Mohammad-Altamash-zia/SmartAqua/Images/PumpSideDivice.png

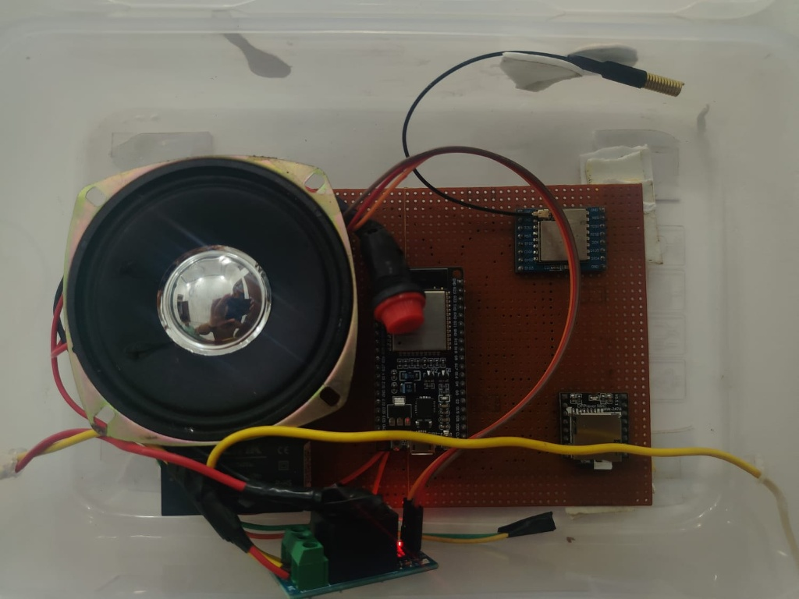
Images/PumpSideDivice.png
