Mohammad-Altamash-zia/SmartAqua/Images/TankSideDivice.png

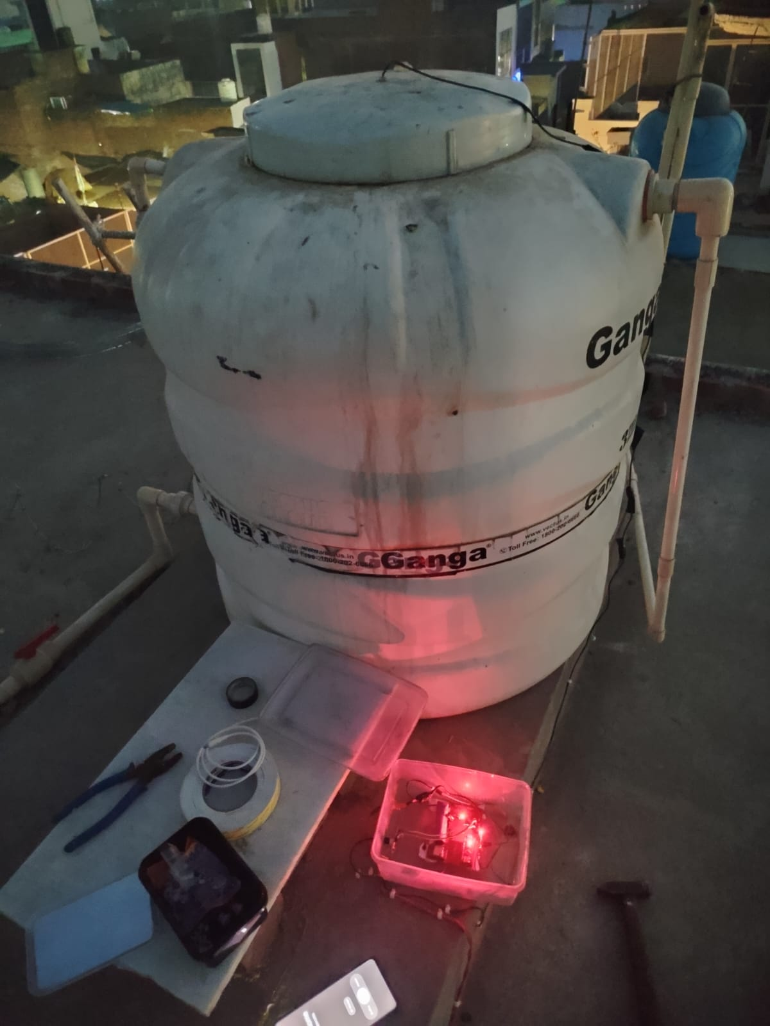
Images/TankSideDivice.png
