Mohammad-Altamash-zia/SmartAqua/SmartAqua_Documentation.docx

# SmartAqua: A Long-Range IoT Water Management System

Comprehensive Project Report & Technical Documentation

Developed by: Mohammad Altamash Zia

Technical Domain: Internet of Things (IoT), Embedded Systems, Wireless Communication (LoRa)

Date: March 13, 2026

## 1. Abstract

The SmartAqua system is a robust, end-to-end IoT solution designed to automate residential water management. It addresses critical inefficiencies in traditional systems, such as water wastage due to overflow, manual monitoring fatigue, and the unreliability of standard WiFi signals in multi-story concrete structures. By utilizing LoRa (Long Range) radio technology, the system achieves stable communication over 1km+ without internet reliance, while integrating an ESP32-based Cloud Gateway for global remote monitoring via ThingsBoard.

## 2. Problem Statement & Objectives

### 2.1 The Problem

- Signal Obstruction: WiFi signals (2.4GHz) struggle to penetrate multiple concrete slabs between a ground-floor room and a roof-top tank.
- Power Instability: Standard electronic controllers fail during the frequent power outages common in some regions.
- Environmental Hazards: Roof-top electronics are subject to extreme heat, heavy monsoon rains, and tampering by local wildlife (monkeys).
- User Feedback: Visual indicators (LEDs) are often ignored; users require audible, natural language alerts.

### 2.2 Objectives

- Develop a low-power wireless sender with a range exceeding 500 meters.
- Implement an Uninterruptible Power Supply (UPS) for 24/7 uptime.
- Create a cloud-connected receiver with automatic motor control and voice notifications.
- Design a ruggedized, physical housing to withstand environmental and animal-induced damage.

## 3. System Architecture

The system follows a distributed architecture consisting of two specialized nodes:

### 3.1 Unit A: The Sender (Roof Node)

This unit is responsible for telemetry acquisition and long-range transmission.

#### 3.1.1 Hardware Specifications

- Controller: Arduino Nano (ATmega328P).
- Radio: LoRa SX1278 (433 MHz).
- Sensor: HC-SR04 Ultrasonic Sensor.
- Logic Shifting: Bi-directional Logic Level Converter (5V to 3.3V) to protect the LoRa module.
- Power Management:
  - Battery Bank: 3x 18650 Li-ion batteries in parallel (Approx. 10,800mAh).
  - Charging: TP4056 Module connected to a 5V 1A wall adapter.
  - Protection: 1N4007 Blocking Diode to prevent nocturnal discharge.

#### 3.1.2 Advanced Firmware Features

- Sensor Isolation (Trick A): The Ultrasonic sensor's VCC is connected to Digital Pin 5. It is powered on for only 200ms per cycle, reducing idle current from 15mA to 0mA.
- Deep Sleep: Utilizes the LowPower.h library to put the MCU into a power-down state.
- Burst Transmission: To ensure the Receiver catches the signal despite WiFi processing delays, the Sender transmits the data packet 3 times per cycle.
- Adaptive Sampling: - Level < 85%: Updates every 2 minutes (Battery Save Mode).
  - Level > 85%: Updates every 8 seconds (Overflow Prevention Mode).

### 3.2 Unit B: The Receiver & Gateway (Room Node)

This unit manages the logic, audio interface, and internet connectivity.

#### 3.2.1 Hardware Specifications

- Controller: ESP32 Dev Module (Dual Core).
- Audio Logic: DFPlayer Mini (MP3-TF-16P).
- Amplification: PAM8403 Class-D 3W Amplifier.
- Speaker: 3-inch 4/8 Ohm full-range speaker.
- Actuator: 1-Channel 5V Relay Module.
- Noise Mitigation: 1k Resistors on Serial lines and a 100uF Capacitor on the amplifier power rail to eliminate high-frequency buzzing.

#### 3.2.2 Logic & Cloud Integration

- ThingsBoard Cloud: Communicates via MQTT to push water level and pump status.
- Voice Feedback: Natural voice alerts (e.g., "Pump Started", "Tank Full") triggered by status changes.
- Safety Watchdog: If no LoRa packet is received for 10 minutes, the system triggers a "Signal Lost" alert and shuts down the pump to prevent uncontrolled running.

## 4. Physical Engineering & Deployment Challenges

### 4.1 Waterproofing & Heat Management

The Roof Unit is housed in an IP65 plastic enclosure. To prevent "greenhouse" heating inside the box, it was strategically placed within a secondary masonry structure.

### 4.2 The "Monkey-Proof" Bunker (Wildlife Protection)

Problem: In the deployment area, monkeys are known to pull cables and chew on plastic enclosures.

Solution: I constructed a protective mini-structure using stone bricks and cement. This provides:

1. Physical Security: A heavy barrier that monkeys cannot move or open.
2. Thermal Insulation: The masonry keeps the Li-ion batteries significantly cooler than direct sun exposure.
3. Cable Management: Wires are routed through the brick gaps and secured, leaving no loose ends for animals to grab.

## 5. Wiring & Connectivity Matrix

### 5.1 Unit A: Sender (Arduino Nano)

The Sender unit requires precise voltage regulation and logic shifting to protect the 3.3V LoRa module from the 5V Arduino signals.

Component | Pin (Component) | Pin (MCU/Other) | Function
Power Management | TP4056 OUT+ | VIN (Nano) | UPS Main Power
| TP4056 OUT- | GND (Common) | Common Ground
Logic Level Converter | HV (High Voltage) | 5V (Nano) | Reference for 5V Signals
| LV (Low Voltage) | 3.3V (Nano) | Reference for 3.3V Signals
| GND | GND | Common Ground
LoRa SX1278 | VCC | 3.3V (Nano) | Power (3.3V strictly)
| GND | GND | Common Ground
| SCK | D13 (via LLC HV1 to LV1) | SPI Clock
| MISO | D12 (via LLC LV2 to HV2) | SPI MISO
| MOSI | D11 (via LLC HV3 to LV3) | SPI MOSI
| NSS (CS) | D10 (via LLC HV4 to LV4) | SPI Chip Select
| RST | D9 (via LLC HV5 to LV5) | Reset
| DIO0 | D2 (via LLC LV6 to HV6) | Interrupt Request
Ultrasonic Sensor | VCC | D5 | Dynamic Power Control
| Trig | D3 | Ultrasonic Trigger
| Echo | D4 | Ultrasonic Echo
| GND | GND | Common Ground

### 5.2 Unit B: Receiver (ESP32)

The Receiver unit integrates WiFi, LoRa, and a multi-stage audio amplification system.

Component | Pin (Component) | Pin (MCU/Other) | Function
LoRa SX1278 | VCC | 3.3V | Power (3.3V)
| GND | GND | Common Ground
| SCK | GPIO 18 | SPI Clock
| MISO | GPIO 19 | SPI MISO
| MOSI | GPIO 23 | SPI MOSI
| NSS (CS) | GPIO 5 | SPI Chip Select
| RST | GPIO 14 | Reset
| DIO0 | GPIO 26 | Interrupt Request
Relay Module | VCC | 5V / VIN | Power (5V)
| IN | GPIO 4 | Motor Switching Logic
| GND | GND | Common Ground
DFPlayer Mini | VCC | 5V / VIN | Power (5V)
| RX | GPIO 17 (via 1kΩ Res) | Serial Data RX
| TX | GPIO 16 | Serial Data TX
| GND | GND | Common Ground
PAM8403 Amp | + / - (Power) | 5V / GND | Filtered via 100uF Cap
| R / L Input | DAC_R / DAC_L (Player) | Audio Signal In
| T Input | GND | Common Audio Ground
Speaker | +/- | R+ / R- | Amplified Audio Output

## 6. Performance Analysis

- Transmission Reliability: 99.8% success rate in "Burst Mode" through 4 concrete slabs.
- Battery Autonomy: Estimated 25-30 days of operation on battery alone (without charger) thanks to Deep Sleep and Sensor Isolation.
- Power UPS: Successful transition from AC to Battery during power cuts with zero system resets.

## 7. Future Scope

- Water Quality Monitoring: Integration of TDS and pH sensors.
- Consumption Analytics: Using ThingsBoard data to predict daily water usage.
- Solar Integration: Replacing the AC charger with high-efficiency panels for 100% off-grid operation.

## 8. Conclusion

The SmartAqua project successfully demonstrates that complex home automation challenges can be solved using low-cost embedded components when combined with intelligent firmware and rugged physical engineering. The system provides a reliable, user-friendly, and highly efficient method for water management in challenging urban environments.
