Mohammad-Altamash-zia/SmartAqua/Images/Dashboard.png

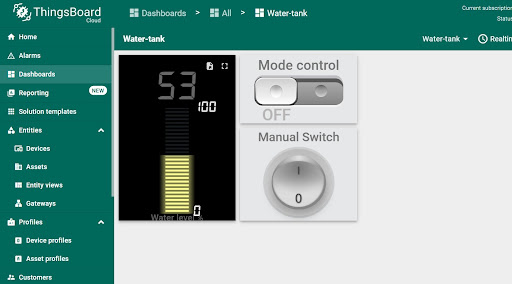
Images/Dashboard.png
