Mohammad-Altamash-zia/SmartAqua/SmartAqua_Schematic.pdf

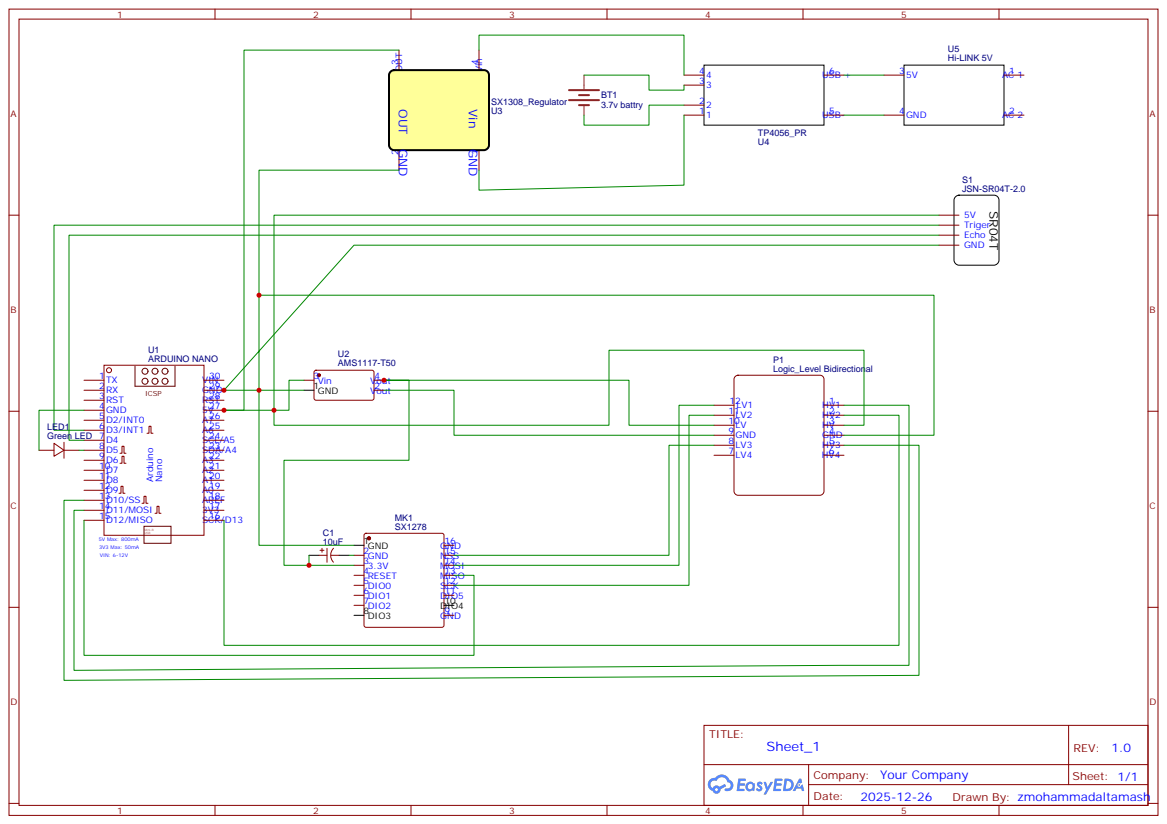
[picture p4: page 1]

DIO4 10 DIO5 11 SCK 12 MISO 13 MOSI 14 NSS 15 GND 16

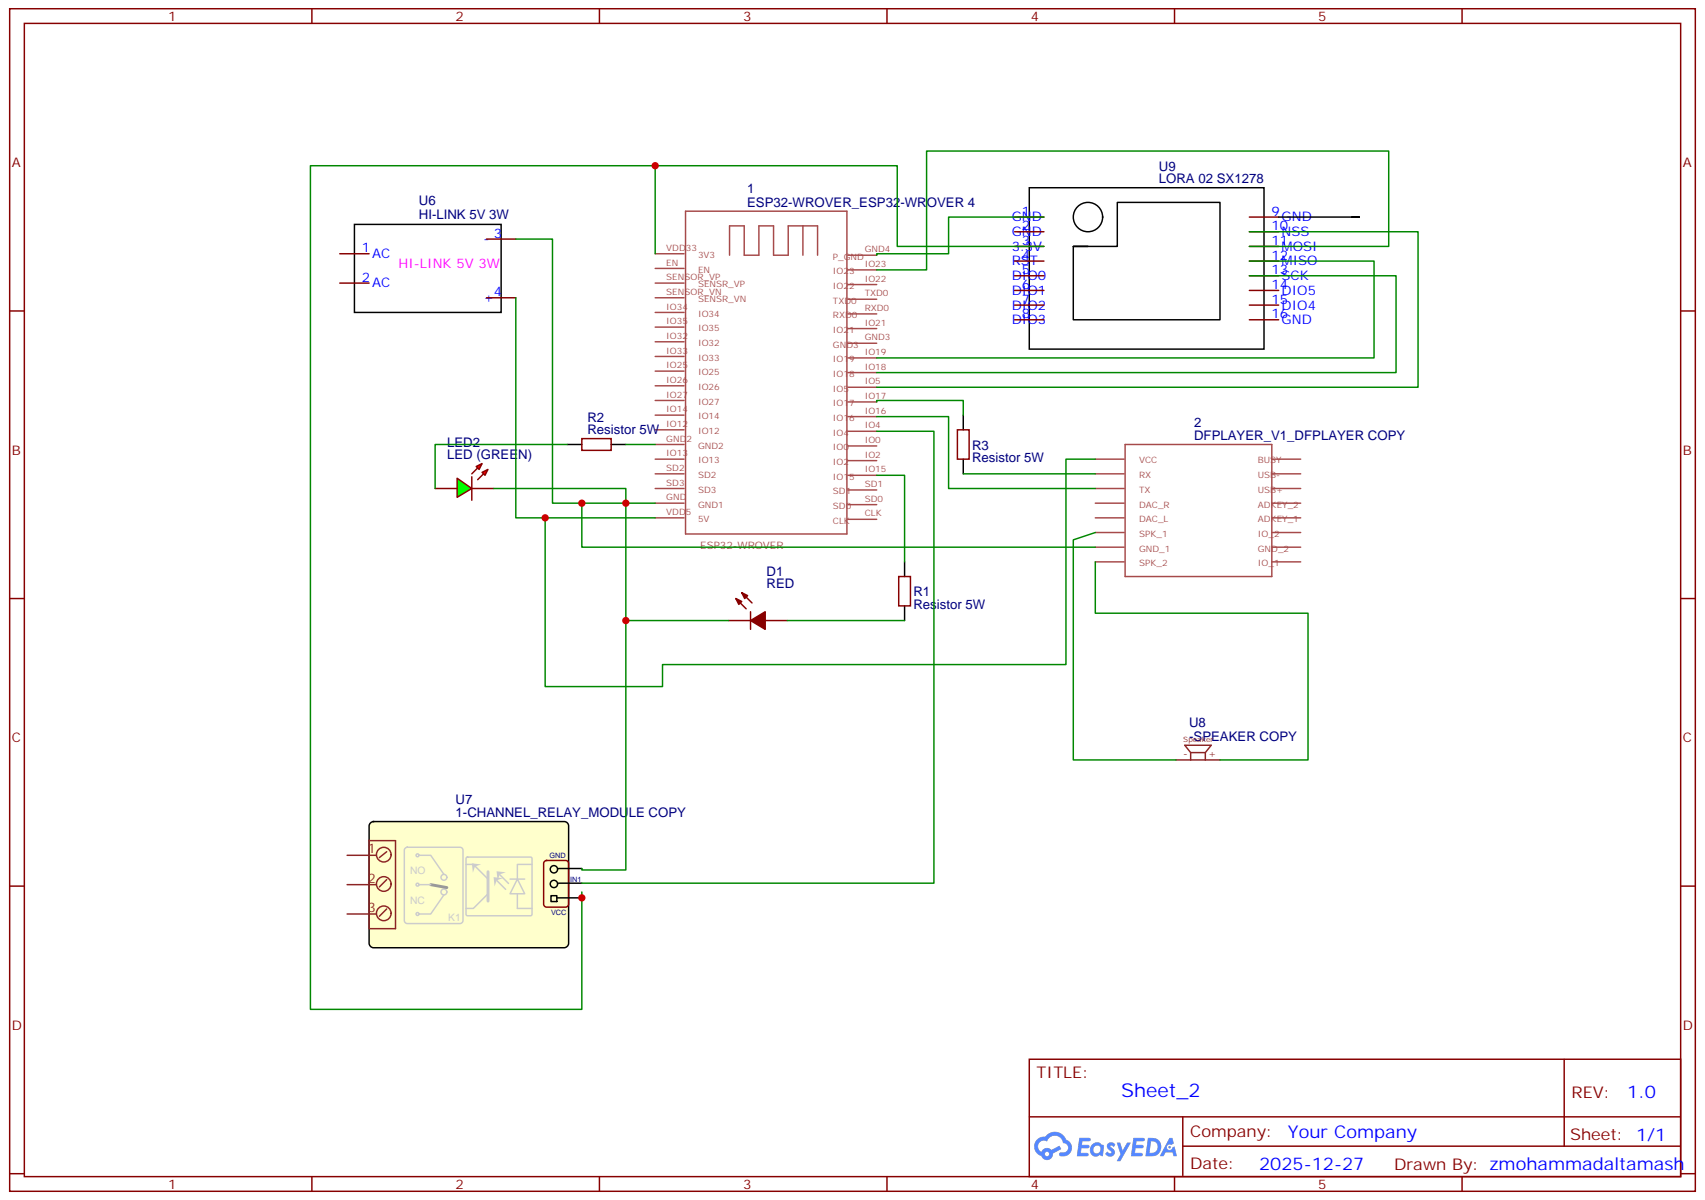
[picture p5: page 2]
